franc0r/francor_drive/DOCS/BOM/bldc_driver_board.xlsx

Referenz | Count | Housing | Name | Link
C1, C2, C3, C19 | 4 | 0805 | 1uF, 6.3V Capacitor | Mouser (https://www.mouser.de/ProductDetail/Yageo/CC0805KKX7R5BB105) |  | x
C4, C5 | 2 | 0805 | 47 nF, 50 V Capacitor | Mouser (https://www.mouser.de/ProductDetail/Yageo/CC0805KRX7R9BB473?qs=sGAEpiMZZMs0AnBnWHyRQMMzfhmH8IQX3Mt0BLFDUPk%3d) |  | x
C7 | 1 | 1206 | 2.2 uF, 50 V Capacitor | Mouser (https://www.mouser.de/ProductDetail/Yageo/CC1206ZKY5V9BB225?qs=sGAEpiMZZMs0AnBnWHyRQCF1lTWZ1EBL4LEkt7Hts1M%3d) |  | x
C9 | 1 | 1206 | 4.7 uF, 50V Capacitor | Mouser (https://www.mouser.de/ProductDetail/Taiyo-Yuden/UMK316AB7475KL-T) |  | x
C11 | 1 | 0805 | 1 uF, 16 V Capacitor | Mouser (https://www.mouser.de/ProductDetail/Yageo/CC0805KKX7R7BB105?qs=sGAEpiMZZMs0AnBnWHyRQMMzfhmH8IQXUrQ8mIpMCrg%3d) |  | x
C6, C8 | 2 | D8 x 10,5 | 220 uF, 50 V Elko | Mouser (https://www.mouser.de/ProductDetail/Panasonic/EEE-FT1H221GP) |  | x
C10 | 1 | D4 x 5,8 | 10 uF, 16 V Elko | Mouser (https://www.mouser.de/ProductDetail/Panasonic/EEE-FK1C100R?qs=sGAEpiMZZMtZ1n0r9vR22cS6GEbW2ftojaLyjEVPo80%3d) |  | x
C13, C16, C17 | 3 | 0603 | 10 pF, 25 V Capacitor | Mouser (https://www.mouser.de/ProductDetail/KEMET/C0603C100J3HACTU) |  | x
C14 | 1 | 0805 | 4.7 nF, 50 V Capacitor | Mouser (https://www.mouser.de/ProductDetail/Yageo/CC0805KRX7R9BB472?qs=sGAEpiMZZMs0AnBnWHyRQMMzfhmH8IQXnRxER173cvw%3d) |  | x
C20, C21, C22 | 3 | 0805 | 1000 pF, 200 V Capacitor | Mouser (https://www.mouser.de/ProductDetail/Yageo/CC0805JRX7RABB102) |  | x
D1, D2 | 2 | SOD-523 | BAT30KFILM Diode | Mouser (https://www.mouser.de/ProductDetail/STMicroelectronics/BAT30KFILM) |  | x
Q1 - Q6 | 6 | TO-252-3 | STD140N6F7 | Mouser (https://www.mouser.de/ProductDetail/STMicroelectronics/STD140N6F7) | Digikey (https://www.digikey.de/product-detail/de/stmicroelectronics/STD140N6F7/497-16937-1-ND/6230273)
R1, R2, R3, R14, R15, R16 | 6 | 0805 | 10k Resistor | Mouser (https://www.mouser.de/ProductDetail/Yageo/RC0805JR-0710KL?qs=sGAEpiMZZMtG0KNrPCHnjXhOLL5qWFv06WF4AgwfKpg%3d) |  | x
R4
R5 | 1 | 0805 | 120 Resistor | Mouser (https://www.mouser.de/ProductDetail/Yageo/RC0805JR-07120RL) |  | x
R9 | 1 | 0805 | 169k Resister | Mouser (https://www.mouser.de/ProductDetail/Susumu/RG2012P-1693-B-T5?qs=sGAEpiMZZMtlubZbdhIBIDg4zQhTDNujcUgPx7U8HgA%3d) |  | x
R10 | 1 | 0805 | 9.31k Resistor | Mouser (https://www.mouser.de/ProductDetail/Panasonic/ERA-6AEB9311V?qs=sGAEpiMZZMtG0KNrPCHnjfgxrTtCmcjjXZy0EIu8rjc%3d) |  | x
R11, R12, R13 | 3 | 0805 | 1k Resistor | Mouser (https://www.mouser.de/ProductDetail/Yageo/AT0805BRD071KL) |  | x
R17, R18, R19 | 3 | 1206 | 0.002 Resistor | Mouser (https://www.mouser.de/ProductDetail/Vishay-Dale/WSLP12062L000FEA) |  | x
IC1 | 1 | HTQPF-48 | BLDC Gate Driver IC | Mouser (https://www.mouser.de/ProductDetail/Texas-Instruments/DRV8305NPHPR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) |  | x
U1 | 1 | SOIC-8 | CAN Transceiver | Mouser (https://www.mouser.de/ProductDetail/Texas-Instruments/SN65HVD232DR?qs=sGAEpiMZZMuo%252bmZx5g6tFL5kWJ52EgZi) |  | x
J2, J3 | 2 | 2x19 RM2.54 | Buchsenleiste | Conrad (https://www.conrad.de/de/econ-connect-buchsenleiste-standard-anzahl-reihen-2-polzahl-je-reihe-19-blg2x19-1-st-1492333.html) |  | x
J6, J7 | 2 | RJ45 | RJ45 Buchse | Conrad (https://www.conrad.de/de/rj45-steckverbinder-buchse-einbau-horizontal-rjju-88-142-e7h-021-schwarz-encitech-3257-0008-02-1-st-1897244.html) |  | x
J5 | 1 | 1x8 RM5.08 | Motor-Connector | Conrad (https://www.conrad.de/de/ptr-stiftgehaeuse-platine-stlz950-polzahl-gesamt-8-rastermass-508-mm-50950085021d-1-st-732027.html) |  | x
J1 | 1 | 1x3 RM5.08 | PWR-Connector | Conrad (https://www.conrad.de/de/ptr-stiftgehaeuse-platine-stlz950-polzahl-gesamt-3-rastermass-508-mm-50950035021f-1-st-731948.html) |  | x
