franc0r/francor_drive/HW/bldc_driver_board/bldc_driver_board.kicad_pcb

## KiCad design HW/bldc_driver_board/bldc_driver_board.kicad_pcb (2019-03-09)

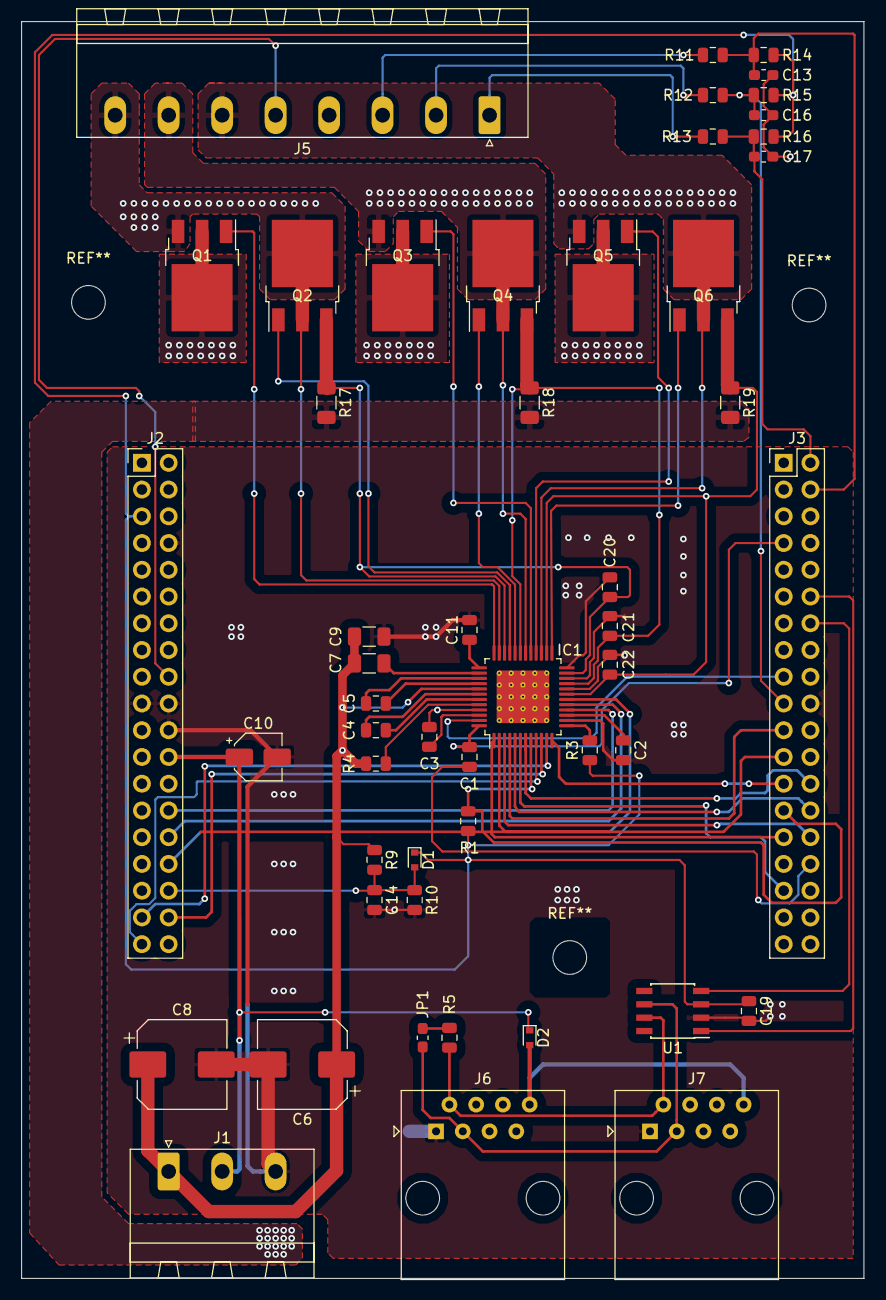
[picture p1: board bldc_driver_board.kicad_pcb from above]

Board: 2 copper layers, 80.0 x 119.4 mm, 51 parts (0 on the bottom side), 58 nets.

Parts:
C1, C2, C3, C11, C19: 1uF; C_0805_2012Metric
C4, C5: 47nF; C_0805_2012Metric
C6, C8: 220uF; CP_Elec_8x10
C7: 2.2uF; C_1206_3216Metric
C9: 4.7uF; C_1206_3216Metric
C10: 10uF; CP_Elec_4x5.8
C13, C16, C17: 10pF; C_0603_1608Metric_Pad1.05x0.95mm_HandSolder
C14: 4.7nF; C_0805_2012Metric
C20, C21, C22: 1000pF; C_0805_2012Metric
D1, D2: BAT30KFILM; D_SOD-523
IC1: DRV8305NPHPR; TQFP-48-1EP_7x7mm_P0.5mm_EP5x5mm_ThermalVias
J1: PWR; PhoenixContact_MSTBA_2,5_3-G-5,08_1x03_P5.08mm_Horizontal
J2: N_CN7; PinHeader_2x19_P2.54mm_Vertical
J3: N_CN10; PinHeader_2x19_P2.54mm_Vertical
J5: Motor; PhoenixContact_MSTBA_2,5_8-G-5,08_1x08_P5.08mm_Horizontal
J6, J7: RJ45; RJ45_Amphenol_54602-x08_Horizontal
JP1: CAN; R_0603_1608Metric_Pad1.05x0.95mm_HandSolder
Q1, Q2, Q3, Q4, Q5, Q6: STD140N6F7; TO-252-3_TabPin2
R1, R3, R14, R15, R16: 10k; R_0805_2012Metric
R4: 100; R_0805_2012Metric
R5: 120; R_0805_2012Metric
R9: 169k; R_0805_2012Metric
R10: 9.31k; R_0805_2012Metric
R11, R12, R13: 1k; R_0805_2012Metric
R17, R18, R19: 0.002R; R_1206_3216Metric
U1: SN65HVD232; SOIC-8_3.9x4.9mm_P1.27mm

Connections:
+5V: J2.18, J5.5
+12V: C10.1, D2.1, J1.2, J2.24
+BATT: C6.1, C7.1, C8.1, C9.1, IC1.41, J1.1, Q1.2, Q3.2, Q5.2, R4.1, R9.1
/AVDD: C2.1, IC1.15
/CAN_H: J6.2, J7.2, R5.1, U1.7
/CAN_L: J6.3, J7.3, JP1.2, U1.6
/CAN_RX: J3.14, U1.4
/CAN_TX: J3.12, U1.1
/CP1H: C4.1, IC1.43
/CP1L: C4.2, IC1.42
/CP2H: C5.1, IC1.39
/CP2L: C5.2, IC1.40
/DVDD: C3.1, IC1.46
/EN_GATE: IC1.1, J3.29
/GHA: IC1.36, Q1.1
/GHB: IC1.29, Q3.1
/GHC: IC1.28, Q5.1
/GLA: IC1.33, Q2.1
/GLB: IC1.32, Q4.1
/GLC: IC1.25, Q6.1
/HALL_A: C13.1, J3.4, R11.1, R14.1
/HALL_B: C16.1, J3.19, R12.1, R15.1
/HALL_C: C17.1, J3.2, R13.1, R16.1
/HALL_IN_A: J5.3, R11.2
/HALL_IN_B: J5.2, R12.2
/HALL_IN_C: J5.1, R13.2
/INHA: IC1.2, J3.23
/INHB: IC1.4, J3.21
/INHC: IC1.6, J3.33
/INLA: IC1.3, J3.30
/INLB: IC1.5, J3.28
/INLC: IC1.7, J3.26
/PWRGD: IC1.13, R3.2
/SCLK: IC1.12, J3.25
/SDI: IC1.10, J2.36
/SDO: IC1.11, J2.35
/SHA: IC1.35, J5.8, Q1.3, Q2.2
/SHB: IC1.30, J5.7, Q3.3, Q4.2
/SHC: IC1.27, J5.6, Q5.3, Q6.2
/SLA: C20.1, IC1.23, IC1.34, Q2.3, R17.1
/SLB: C21.1, IC1.21, IC1.31, Q4.3, R18.1
/SLC: C22.1, IC1.19, IC1.26, Q6.3, R19.1
/SO1: IC1.16, J2.28
/SO2: IC1.17, J2.30
/SO3: IC1.18, J2.32
/VBUS: C14.1, D1.2, J2.34, R9.2, R10.1
/VCPH: C7.2, IC1.38
/VCP_LSD: C11.1, IC1.37
/WAKE: IC1.47, J3.17
/~FAULT: IC1.8, J3.27, R1.2
/~SCS: IC1.9, J2.37
GND: C2.2, C3.2, C6.2, C8.2, C9.2, C10.2, C11.2, C13.2, C14.2, C16.2, C17.2, C19.2, C20.2, C21.2, C22.2, IC1.14, IC1.20, IC1.22, IC1.24, IC1.45, J1.3, J2.8, J2.19, J2.20, J2.22, J3.20, J5.4, J6.1, J7.1, R10.2, R17.2, R18.2, R19.2, U1.2
GNDA: C1.2, J3.32
unnamed: D2.2, J6.8, J7.8
unnamed: IC1.44, R4.2
unnamed: JP1.1, R5.2
VDD: C19.1, D1.1, J2.5, R1.1, R3.1, R14.2, R15.2, R16.2, U1.3
VDDA: C1.1, IC1.48, J3.7
