franc0r/francor_drive/SW/FW/bldc_driver_firmware.ioc

Mcu.UserName=STM32F446RETx
PA0-WKUP.GPIO_Label=SO1
PA0-WKUP.Signal=ADCx_IN0
PA1.GPIO_Label=SO2
PA1.Signal=ADCx_IN1
PA10.GPIO_Label=INHC
PA10.Signal=S_TIM1_CH3
PA11.GPIO_Label=CAN_RX
PA11.Signal=CAN1_RX
PA12.GPIO_Label=CAN_TX
PA12.Signal=CAN1_TX
PA13.GPIO_Label=TMS
PA13.Signal=SYS_JTMS-SWDIO
PA14.GPIO_Label=TCK
PA14.Signal=SYS_JTCK-SWCLK
PA2.GPIO_Label=USART_TX
PA2.Signal=USART2_TX
PA3.GPIO_Label=USART_RX
PA3.Signal=USART2_RX
PA4.GPIO_Label=SO3
PA4.Signal=ADCx_IN4
PA5.GPIO_Label=LD2 [Green Led]
PA5.Signal=GPIO_Output
PA8.GPIO_Label=INHA
PA8.Signal=S_TIM1_CH1
PA9.GPIO_Label=INHB
PA9.Signal=S_TIM1_CH2
PB0.GPIO_Label=VBUS
PB0.Signal=ADCx_IN8
PB10.GPIO_Label=SPI_SCK
PB10.Signal=SPI2_SCK
PB13.GPIO_Label=INLA
PB13.Signal=TIM1_CH1N
PB14.GPIO_Label=INLB
PB14.Signal=TIM1_CH2N
PB15.GPIO_Label=INLC
PB15.Signal=TIM1_CH3N
PB3.GPIO_Label=SWO
PB3.Signal=SYS_JTDO-SWO
PB4.GPIO_Label=nFAULT
PB4.Signal=GPIO_Input
PB5.GPIO_Label=EN_GATE
PB5.Signal=GPIO_Output
PB6.GPIO_Label=WAKE
PB6.Signal=GPIO_Output
PC1.GPIO_Label=SPI_MO
PC1.Signal=SPI2_MOSI
PC13.GPIO_Label=B1 [Blue PushButton]
PC13.Signal=GPXTI13
PC14-OSC32_IN.Signal=RCC_OSC32_IN
PC15-OSC32_OUT.Signal=RCC_OSC32_OUT
PC2.GPIO_Label=SPI_MI
PC2.Signal=SPI2_MISO
PC6.GPIO_Label=HALL_A
PC6.Signal=S_TIM3_CH1
PC7.GPIO_Label=HALL_B
PC7.Signal=S_TIM3_CH2
PC8.GPIO_Label=HALL_C
PC8.Signal=S_TIM3_CH3
PH0-OSC_IN.Signal=RCC_OSC_IN
PH1-OSC_OUT.Signal=RCC_OSC_OUT
