franc0r/francor_drive/(commit log)

2019-02-16 -- Added BOM for bldc driver board
    [bldc_driver_board.xlsx]
2019-02-16 -- Added example schematic
2019-02-16 -- Added schematic for BLDC driver board
    [bldc_driver_board.sch]
2019-02-17 -- Continued adding BOM parts -- Removed Current Sense filtering
    [bldc_driver_board.sch, bldc_driver_board.xlsx]
2019-02-17 -- Added footprings
    [bldc_driver_board.sch]
2019-02-17 -- Fixed wrong footpring of CP
    [bldc_driver_board.sch]
2019-02-20 -- Started PCB design -> Placed parts
    [bldc_driver_board.kicad_pcb]
2019-02-20 -- Added elecrow design rules
    [bldc_driver_board.kicad_pcb]
2019-02-20 -- Continued pcb layout
    [bldc_driver_board.kicad_pcb, bldc_driver_board.sch]
2019-02-21 -- Continued PCB design
    [bldc_driver_board.kicad_pcb, bldc_driver_board.sch]
2019-02-26 -- Continued routing and removed MOSFET Capacitors
    [bldc_driver_board.kicad_pcb, bldc_driver_board.sch]
2019-02-26 -- Added borders
    [bldc_driver_board.kicad_pcb]
2019-02-26 -- Fixed loose wire
    [bldc_driver_board.kicad_pcb]
2019-02-26 -- Fixed ground connection
    [bldc_driver_board.kicad_pcb]
2019-02-26 -- Added fields for BLDC output
    [bldc_driver_board.kicad_pcb]
2019-02-27 -- Added surfaces
    [bldc_driver_board.kicad_pcb]
2019-02-27 -- Added lines to encoder connector
    [bldc_driver_board.kicad_pcb]
2019-02-27 -- Replaced motorconnector and added drill holes
    [bldc_driver_board.kicad_pcb, bldc_driver_board.sch]
2019-02-27 -- Added thermal pads and connections to UVW
    [bldc_driver_board.kicad_pcb]
2019-02-27 -- Small fixes of planes
    [bldc_driver_board.kicad_pcb]
2019-02-27 -- Added GND Planes
    [bldc_driver_board.kicad_pcb]
2019-02-27 -- Smal changes
    [bldc_driver_board.kicad_pcb]
2019-02-28 -- Added panels for drill holes
    [bldc_driver_board.kicad_pcb]
2019-02-28 -- Fixed unwired CAN chip
    [bldc_driver_board.kicad_pcb]
2019-02-28 -- Added Gerber Files for JBLPCB Production
    [bldc_driver_board-B.CrtYd.gbr, bldc_driver_board-B.Cu.gbr, bldc_driver_board-B.Mask.gbr, bldc_driver_board-B.Paste.gbr, bldc_driver_board-B.SilkS.gbr, bldc_driver_board-Edge.Cuts.gbr, bldc_driver_board-F.CrtYd.gbr, bldc_driver_board-F.Cu.gbr]
2019-03-04 -- Modified part list
    [bldc_driver_board.xlsx]
2019-03-04 -- Added connectors to partlist
    [bldc_driver_board.xlsx]
2019-03-09 -- Added comment due to forgotton resistory
    [bldc_driver_board.xlsx]
2019-03-09 -- Fixed missing nSCS pin error
    [bldc_driver_board.kicad_pcb, bldc_driver_board.sch]
